Z2Z-GuGu/PMIC-RK818/Picture/WechatIMG1056.jpg

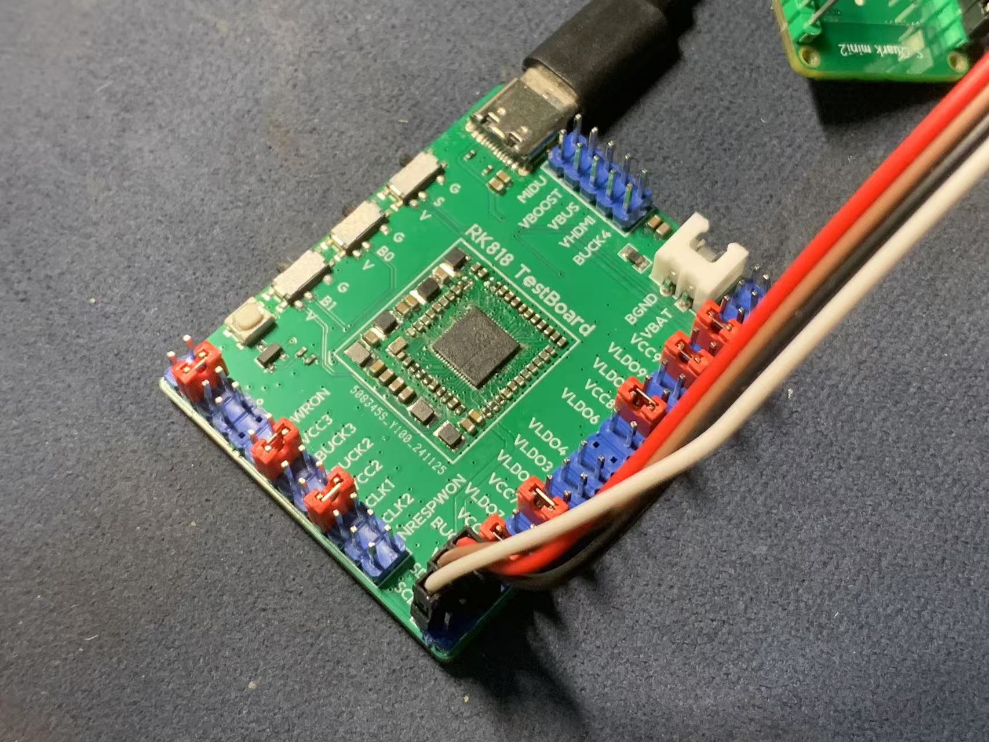
Picture/WechatIMG1056.jpg
