Z2Z-GuGu/PMIC-RK818/README.md

# PMIC-RK818
 A project attempting to drive the RK818 using a microcontroller (currently using ESP32) to achieve basic functionalities.

## Roadmap:

### hardware component
- [x] schematic diagram
- [x] PCB
- [x] Handmade SMT
### Software section
- [x] RTC testing
- [x] DCDC+LDO+BOOST switch
- [x] DCDC+LDO+BOOST voltage regulation
- [ ] DCDC current test
- [ ] Switch button logic test
- [ ] Charging+current testing
