Z2Z-GuGu/PMIC-RK818/note.md

实验记录
## 25/02/06:

1. 使用I2C-tool工具扫描I2C地址：无
2. chatGPT回复：0x0B
3. sdk中查询（设备树）：0x2C
4. 重新焊接RK818，在i2c-tool中成功扫描出0x2c：
```shell
i2c-tools> i2cdetect
     0  1  2  3  4  5  6  7  8  9  a  b  c  d  e  f
00: -- -- -- -- -- -- -- -- -- -- -- -- -- -- -- -- 
10: -- -- -- -- -- -- -- -- -- -- -- -- 1c -- -- -- 
20: -- -- -- -- -- -- -- -- -- -- -- -- -- -- -- -- 
30: -- -- -- -- -- -- -- -- -- -- -- -- -- -- -- -- 
40: -- -- -- -- -- -- -- -- -- -- -- -- -- -- -- -- 
50: -- -- -- -- -- -- -- -- -- -- -- -- -- -- -- -- 
60: -- -- -- -- -- -- -- -- -- -- -- -- -- -- -- -- 
70: -- -- -- -- -- -- -- -- -- -- -- -- -- -- -- -- 
i2c-tools> 
```
5. 在macOS VScode中在原有idfsdk基础上搭建ESP-IDF（VScode）环境
6. 创建GitHub工程

## 25/02/07:

1. 验证RTC功能：正常

   ```shell
   i2c-tools> i2cdump -c 0x1c
        0  1  2  3  4  5  6  7  8  9  a  b  c  d  e  f    0123456789abcdef
   00: 31 59 08 21 01 13 01 00 00 00 00 01 01 00 00 00    1Y?!???....??...
   10: 00 82 00 00 00 00 00 81 81 00 00 00 00 00 00 00    .?.....??.......
   20: 02 54 00 3f 5c 00 00 0a 00 00 00 15 5c 02 1a 00    ?T.?\..?...?\??.
   30: 00 00 1a 00 00 00 02 02 00 00 0a 00 00 00 00 00    ..?...??..?.....
   40: 00 00 00 00 00 00 00 00 00 00 00 00 00 00 01 00    ..............?.
   50: 00 00 00 00 6c 60 00 00 00 00 00 00 00 00 00 00    ....l`..........
   60: 00 00 8f 04 44 00 00 00 00 00 00 00 00 00 00 00    ..??D...........
   70: 00 df 27 00 3c 00 00 00 0a 24 00 02 32 00 01 00    .?'.<...?$.?2.?.
   
   i2c-tools> i2cdump -c 0x1c
        0  1  2  3  4  5  6  7  8  9  a  b  c  d  e  f    0123456789abcdef
   00: 43 00 09 21 01 13 01 00 00 00 00 01 01 00 00 00    C.?!???....??...
   10: 00 82 00 00 00 00 00 81 81 00 00 00 00 00 00 00    .?.....??.......
   20: 02 54 00 3f 5c 00 00 0a 00 00 00 15 5c 02 1a 00    ?T.?\..?...?\??.
   30: 00 00 1a 00 00 00 02 02 00 00 0a 00 00 00 00 00    ..?...??..?.....
   40: 00 00 00 00 00 00 00 00 00 00 00 00 00 00 01 00    ..............?.
   50: 00 00 00 00 6c 60 00 00 00 00 00 00 00 00 00 00    ....l`..........
   60: 00 00 8f 04 44 00 00 00 00 00 00 00 00 00 00 00    ..??D...........
   70: 00 df 27 00 3c 00 00 00 0a 24 00 02 32 00 01 00    .?'.<...?$.?2.?.
   ```

   时间符合默认值；时分秒运行正常

2. 充电0x21 bit6:充电器已插入：正常

3. 控制电源开启关闭：0x23,0x24

   + VLDO5/9 DCDC2/4 VSW异常：不能开启
   + 0x23 bit7打开导致啸叫 OTG功能？

4. DCDC欠压寄存器：0x27:表明DCDC2/4异常

5. DCDC PowerGood：0x2B：显示DCDC2/4 not good LDO9:not good

6. LDO PowerGood：0x2C：0xff

7. DCDC1:电压设置：0x2F：0x00-0x3F～0.721V-1.518V

8. DCDC2:电压设置：0x33：0x00-0x3F～0.721V-1.518V 设置失败

9. DCDC3:电压设置：电阻设置

10. DCDC4:电压设置：0x38：0x00-0x3F～V-V 设置失败

11. LDO1电压设置：0x3B：0x00-0x10～1.8V-3.42V 设置成功

12. LDO2电压设置：0x3D：0x00-0x10～1.8V-3.42V 设置成功

13. LDO3电压设置：0x3F：0x00-0x0F～0.797V-2.478V 设置成功

14. LDO4电压设置：0x41：0x00-0x10～1.8V-3.388V 设置成功

15. LDO5电压设置：0x43：0x00-0x10～1.8V-3.388V 设置失败

16. LDO6电压设置：0x45：0x00-0x10～0.797V-2.480V 设置成功

17. LDO7电压设置：0x47：0x00-0x10～0.807V-2.501V 设置成功

18. LDO8电压设置：0x49：0x00-0x10～1.8V-3.383V 设置成功

19. LDO9/BOOST电压设置：0x54：BOOST设置成功 LDO9失败

20. ILIMIT暂时做不了，没负载测试仪
