Z2Z-GuGu/PMIC-RK818/Hardware/SCH_RK818_TestBoard.pdf

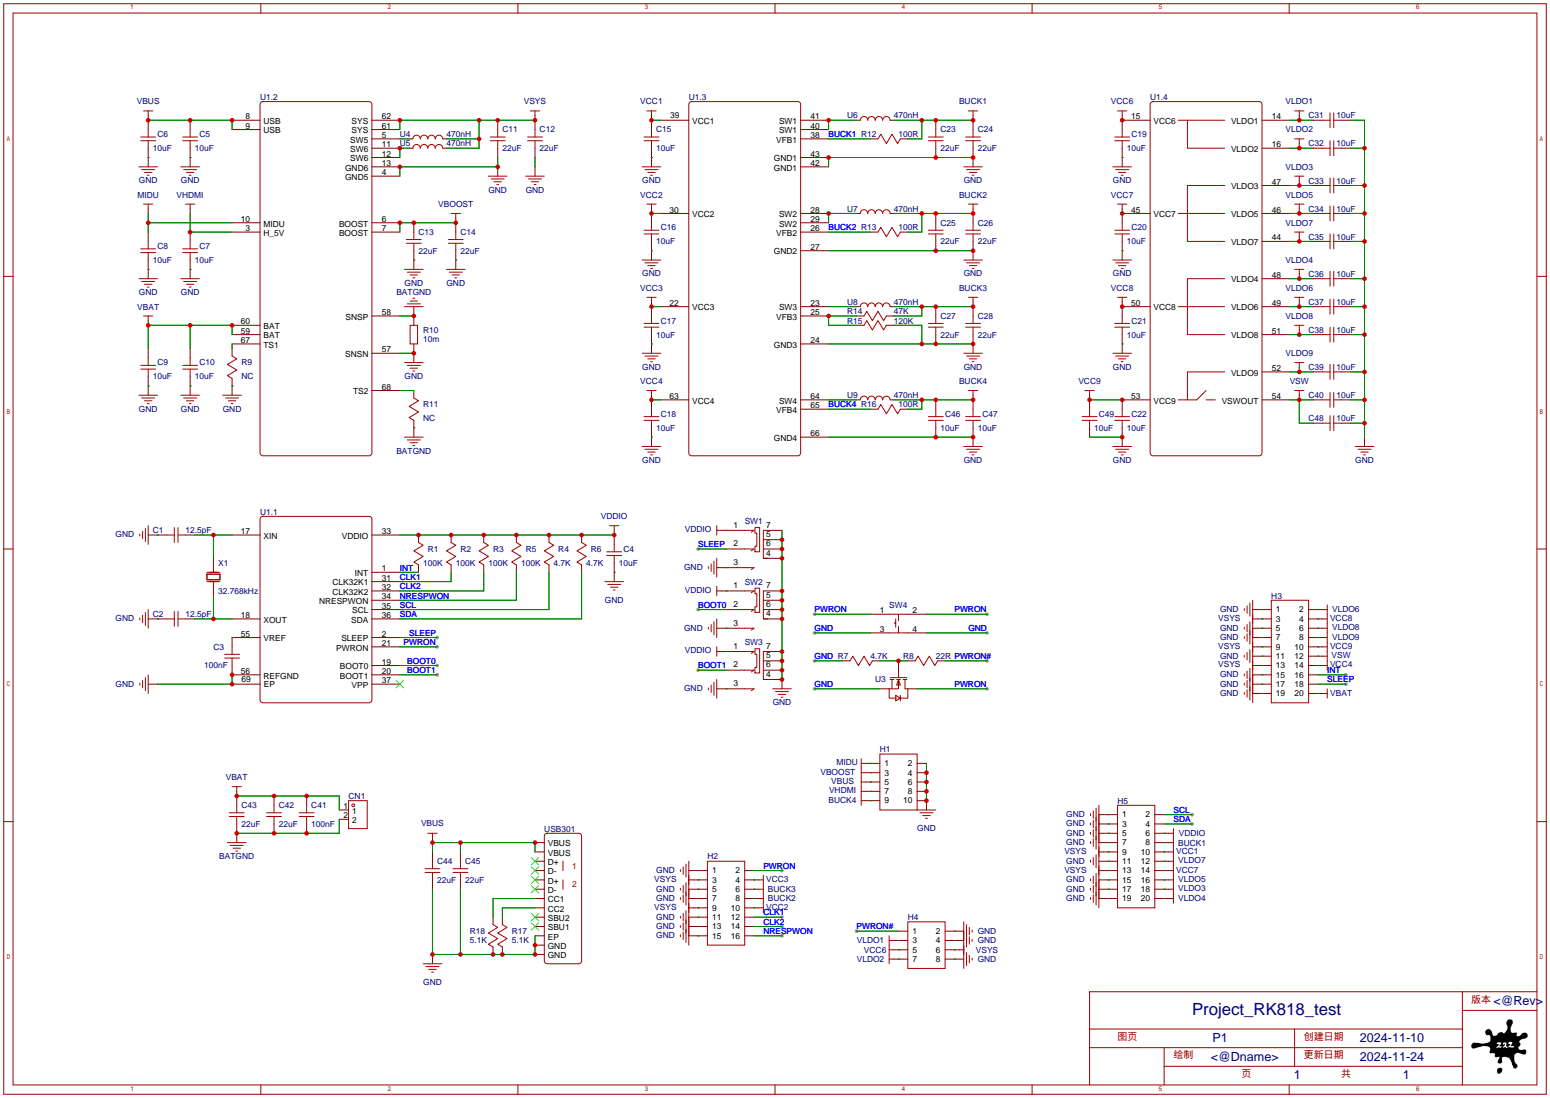
[picture p2: page 1]

P1 图页 | 2024-11-10 创建日期

绘制 <@Dname> | 更新日期 2024-11-24
