Z2Z-GuGu/PMIC-RK818/(list of files, drawings)

Other design files:
Hardware/ProProject_Project_RK818_TestBoard.epro
