Z2Z-GuGu/PMIC-RK818/(commit log)

2025-02-06 Add test code: "i2c-tool"
    [partitions_example.csv]
2025-02-07 update I2C Register test note
    RTC + DCDC + LDO test result
2025-02-07 Add hardware test version file
    [ProProject_Project_RK818_TestBoard.epro]
